raymirabel/LoRaX1/README.md

# LoRaX1
Analizador de red eléctrica comunicación LoRa
